alxhoff/Nixie-tube-clock/README.md

# stm32_nixie_clock_firmware
Firmware for a nixie tube clock based on STM32 hal libraries
