alxhoff/Nixie-tube-clock/hardware/nixie_2_digit_board/nixie_2_digit_board.kicad_pcb

## KiCad design hardware/nixie_2_digit_board/nixie_2_digit_board.kicad_pcb (2022-05-30)

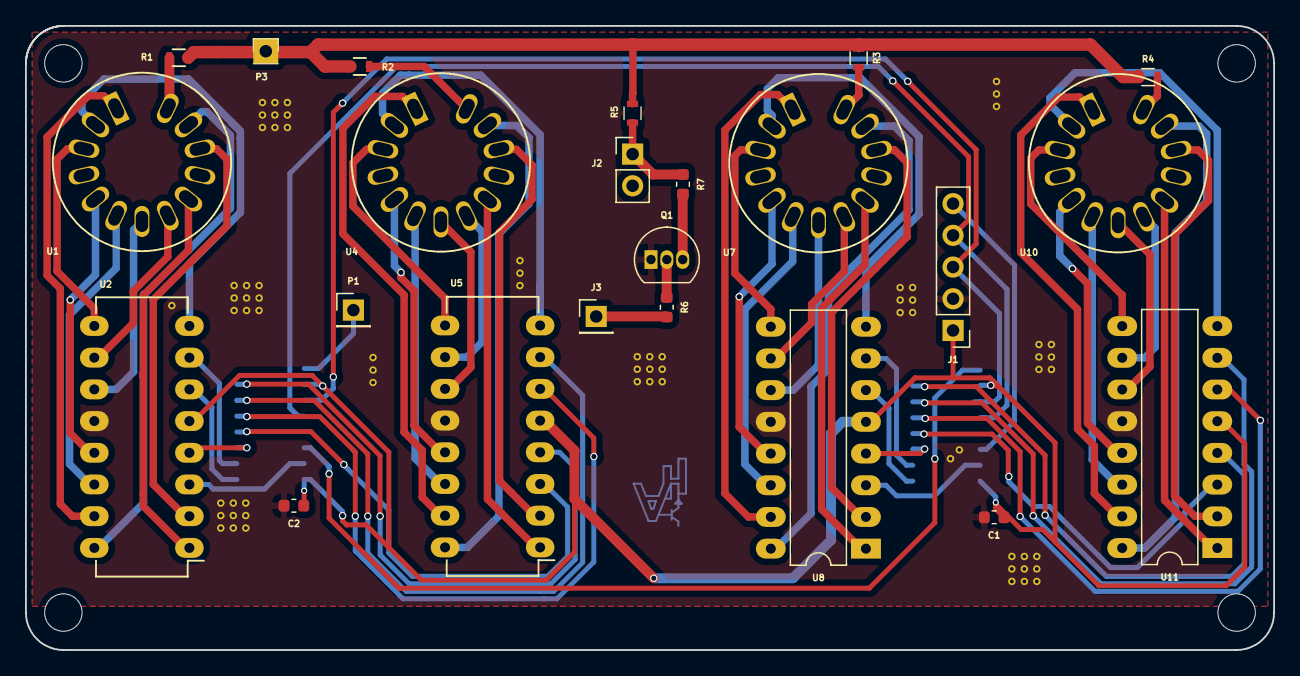
[picture p2: board nixie_2_digit_board.kicad_pcb from above]

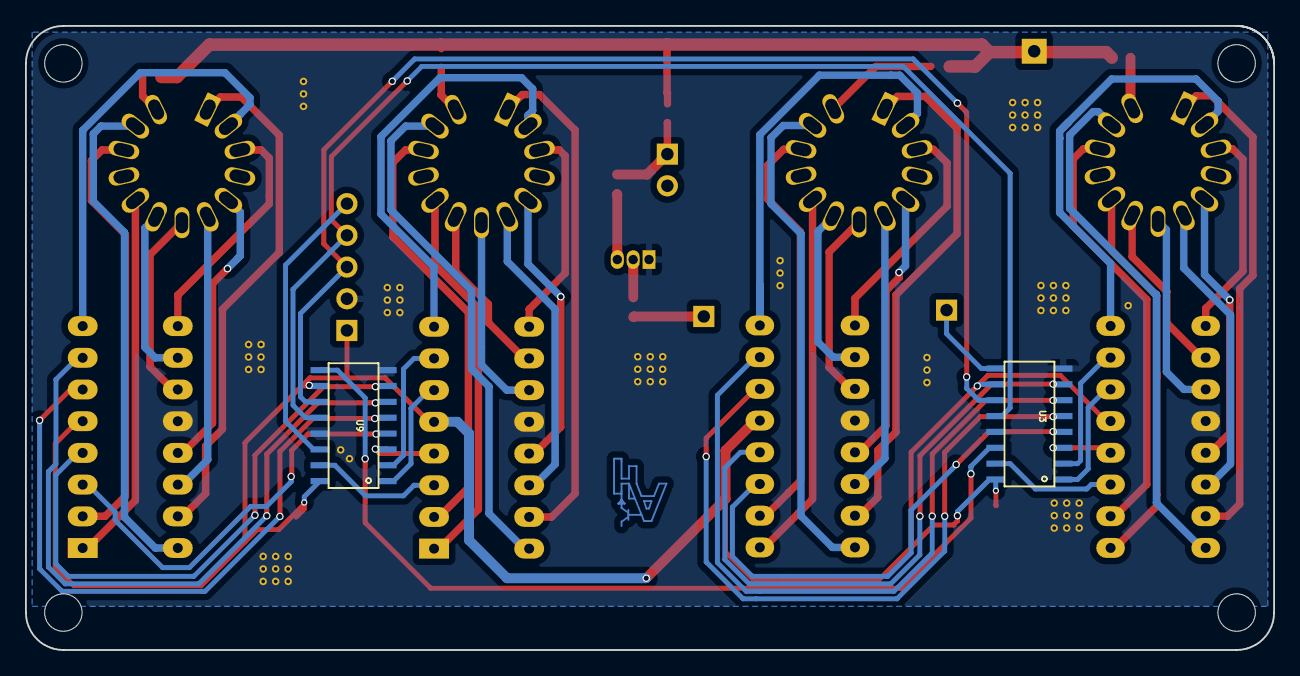
[picture p3: board nixie_2_digit_board.kicad_pcb from below]

Board: 2 copper layers, 100.0 x 50.0 mm, 26 parts (3 on the bottom side), 72 nets.

Parts:
C1, C2: 0.1uF; C_0603_1608Metric
J1: Conn_01x05; Pin_Header_Straight_1x05_Pitch2.54mm
J2: Dot Connection; Pin_Header_Straight_1x02_Pitch2.54mm
J3: GPIO in for dot; PinHeader_1x01_P2.54mm_Vertical
P1: CONN_01X01; Pin_Header_Straight_1x01_Pitch2.54mm
P3: CONN_01X01; Pin_Header_Straight_1x01
Q1: MPSA42; TO-92_Inline
R1, R2, R3, R4, R5: 15K; R_0603
R6: 10K; R_0603_1608Metric
R7: 15K; R_0603_1608Metric
U1, U4, U7, U10: 570Nixie; Nixie-570M-573M
U2, U5, U8, U11: SN74141-BCD-DEC-DECODE; DIP-16_W7.62mm_LongPads
U3, U9: SN43HC595; SOP16L
U6: Logo

Connections:
180V: P3.1, R1.1, R2.1, R3.1, R4.1, R5.2
+5V: C1.1, C2.1, J1.1, U2.5, U3.10, U3.16, U5.5, U8.5, U9.10, U9.16, U11.5
DOT_CTRL: J3.1, R6.2
GND: C1.2, C2.2, J1.2, Q1.1, U2.12, U3.8, U3.13, U5.12, U8.12, U9.8, U9.13, U11.12
unnamed: J2.1, R5.1, R7.1
unnamed: P1.1, U3.9
unnamed: Q1.2, R6.1
unnamed: Q1.3, R7.2
unnamed: R1.2, U1.13
unnamed: R2.2, U4.13
unnamed: R3.2, U7.13
unnamed: R4.2, U10.13
unnamed: U1.1, U2.15
unnamed: U1.2, U2.8
unnamed: U1.3, U2.9
unnamed: U1.5, U2.13
unnamed: U1.6, U2.14
unnamed: U1.7, U2.11
unnamed: U1.8, U2.10
unnamed: U1.9, U2.1
unnamed: U1.11, U2.2
unnamed: U1.12, U2.16
unnamed: U2.3, U3.15
unnamed: U2.4, U3.3
unnamed: U2.6, U3.1
unnamed: U2.7, U3.2
unnamed: U3.4, U5.3
unnamed: U3.5, U5.6
unnamed: U3.6, U5.7
unnamed: U3.7, U5.4
unnamed: U4.1, U5.15
unnamed: U4.2, U5.8
unnamed: U4.3, U5.9
unnamed: U4.5, U5.13
unnamed: U4.6, U5.14
unnamed: U4.7, U5.11
unnamed: U4.8, U5.10
unnamed: U4.9, U5.1
unnamed: U4.11, U5.2
unnamed: U4.12, U5.16
unnamed: U7.1, U8.15
unnamed: U7.2, U8.8
unnamed: U7.3, U8.9
unnamed: U7.5, U8.13
unnamed: U7.6, U8.14
unnamed: U7.7, U8.11
unnamed: U7.8, U8.10
unnamed: U7.9, U8.1
unnamed: U7.11, U8.2
unnamed: U7.12, U8.16
unnamed: U8.3, U9.15
unnamed: U8.4, U9.3
unnamed: U8.6, U9.1
unnamed: U8.7, U9.2
unnamed: U10.1, U11.15
unnamed: U10.2, U11.8
unnamed: U10.3, U11.9
unnamed: U10.5, U11.13
unnamed: U10.6, U11.14
unnamed: U10.7, U11.11
unnamed: U10.8, U11.10
unnamed: U10.9, U11.1
unnamed: U10.11, U11.2
unnamed: U10.12, U11.16
unnamed: U9.4, U11.3
unnamed: U9.7, U11.4
unnamed: U9.5, U11.6
unnamed: U9.6, U11.7
SHIFT_LATCH_CLOCK: J1.4, U3.12, U9.12
SHIFT_OUT: U3.14, U9.9
SHIFT_SERIAL_CLOCK: J1.3, U3.11, U9.11
SHIFT_SER_DATA: J1.5, U9.14
