alxhoff/Nixie-tube-clock/hardware/nixie_control_board/nixie_control_board.kicad_pcb

## KiCad design hardware/nixie_control_board/nixie_control_board.kicad_pcb (2022-05-30)

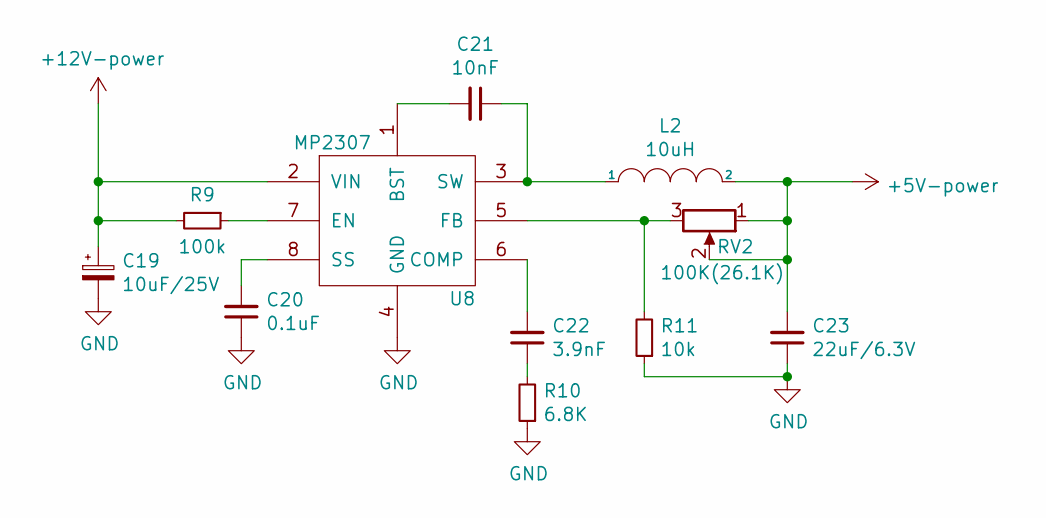
[picture p4: schematic buck_converter.kicad_sch]

Parts:
C19: 10uF/25V; C_1210_3225Metric
C20: 0.1uF; C_0603_1608Metric
C21: 10nF; C_0603_1608Metric
C22: 3.9nF; C_0603_1608Metric
C23: 22uF/6.3V; C_1206_3216Metric
L2: 10uH; Inductor_Wurth_HCI-7030
R9: 100k; R_0603_1608Metric
R10: 6.8K; R_0603_1608Metric
R11: 10k; R_0603_1608Metric
RV2: 100K(26.1K); Potentiometer_Trimmer-EVM3E
U8: MP2307; SOIC-8_3.9x4.9mm_P1.27mm

Connections:
+5V: C23.2, L2.2, RV2.1, RV2.2; also elsewhere on the board
+12V: C19.1, R9.2, U8.2 (VIN); also elsewhere on the board
GND: C19.2, C20.1, C23.1, R10.1, R11.1, U8.4 (GND); also elsewhere on the board
unnamed: C20.2, U8.8 (SS)
unnamed: C21.1, L2.1, U8.3 (SW)
unnamed: C21.2, U8.1 (BST)
unnamed: C22.1, R10.2
unnamed: C22.2, U8.6 (COMP)
unnamed: R9.1, U8.7 (EN)
unnamed: R11.2, RV2.3, U8.5 (FB)

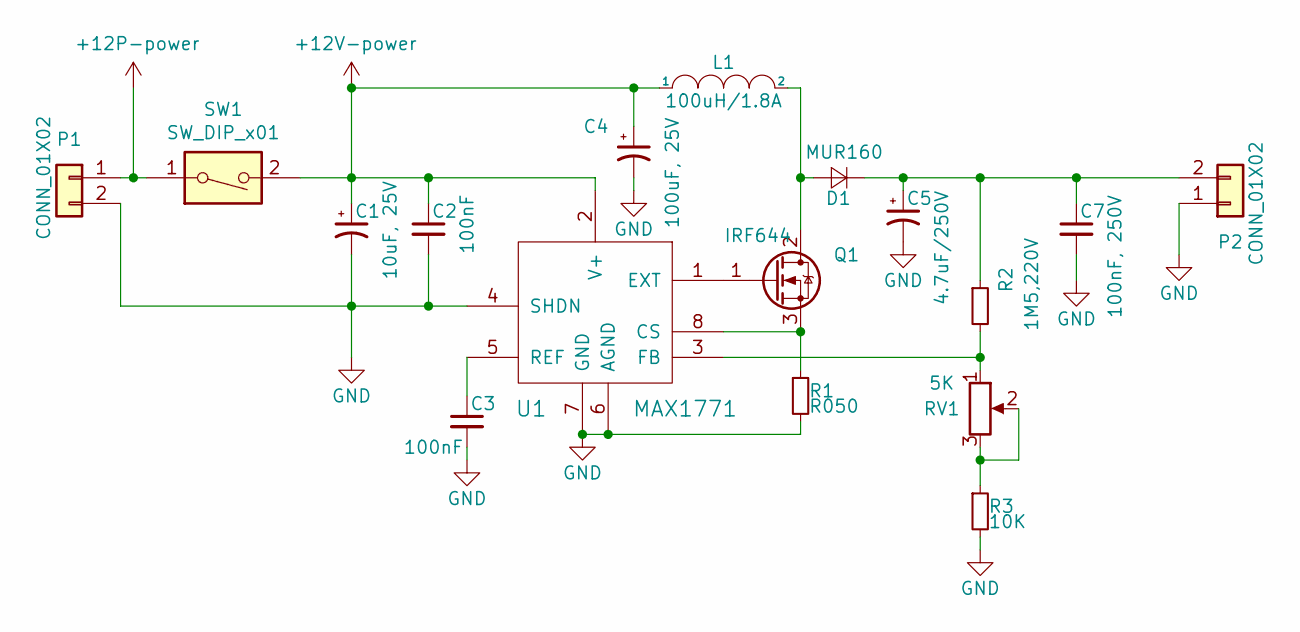
[picture p5: schematic nixie_supply.kicad_sch]

Parts:
C1: 10uF, 25V; C_1210_3225Metric
C2, C3: 100nF; C_0805_2012Metric
C4: 100uF, 25V; CP_EIA-7343-15_Kemet-W
C5: 4.7uF/250V; CP_Radial_D8.0mm_P3.80mm
C7: 100nF, 250V; C_1206_3216Metric
D1: MUR160; Diode_DO-41_SOD81_Horizontal_RM10
L1: 100uH/1.8A; L_12x12mm_H8mm
P1, P2: CONN_01X02; Power_connectors_5mm
Q1: IRF644; TO-220-3_Horizontal_TabDown
R1: R050; R_2512_6332Metric
R2: 1M5,220V; R_2512_6332Metric
R3: 10K; R_0603_1608Metric
RV1: 5K; Potentiometer_Trimmer-EVM3E
SW1: SW_DIP_x01; PinHeader_1x02_P2.54mm_Vertical
U1: MAX1771; SOP-8_3.9x4.9mm_P1.27mm

Connections:
+12P: P1.1, SW1.1
+12V: C1.1, C2.1, C4.1, L1.1, SW1.2, U1.2 (V+); also elsewhere on the board
GND: C1.2, C2.2, C3.2, C4.2, C5.2, C7.2, P1.2, P2.1, R1.2, R3.2, U1.4 (SHDN), U1.6 (AGND), U1.7 (GND); also elsewhere on the board
unnamed: C3.1, U1.5 (REF)
unnamed: C5.1, C7.1, D1.1 (K), P2.2, R2.1
unnamed: D1.2 (A), L1.2, Q1.2 (D)
unnamed: Q1.3 (S), R1.1, U1.8 (CS)
unnamed: R2.2, RV1.1, U1.3 (FB)
unnamed: R3.1, RV1.2, RV1.3
unnamed: Q1.1 (G), U1.1 (EXT)

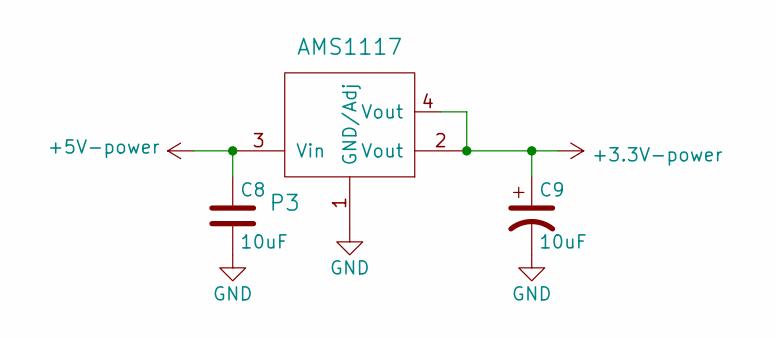
[picture p6: schematic 3v3_power.kicad_sch]

Parts:
C8, C9: 10uF; C_0603_1608Metric
P3: AMS1117; SOT-223

Connections:
+3V3: C9.1, P3.2 (Vout), P3.4 (Vout); also elsewhere on the board
+5V: C8.1, P3.3 (Vin); also elsewhere on the board
GND: C8.2, C9.2, P3.1 (GND/Adj); also elsewhere on the board

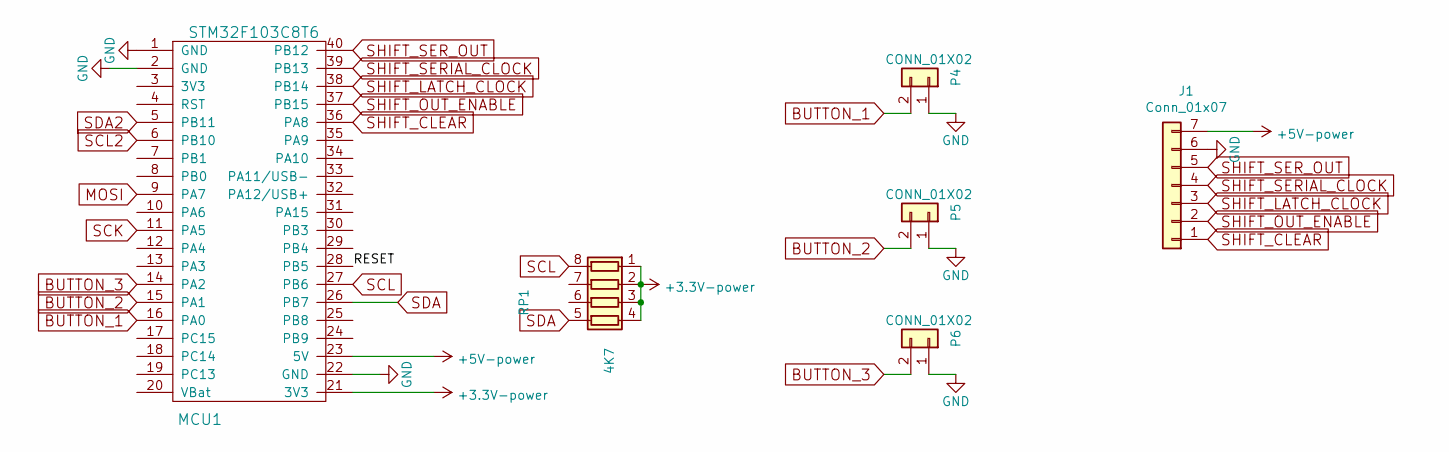
[picture p7: schematic controller.kicad_sch]

Parts:
J1: Conn_01x07; Pin_Header_Straight_1x07_Pitch2.54mm
MCU1: STM32F103C8T6
P4, P5, P6: CONN_01X02; PinHeader_1x02_P2.54mm_Vertical
RP1: 4K7; R_Array_Convex_4x0402

Connections:
+3V3: MCU1.21 (3V3), RP1.1 (R1.1), RP1.2 (R2.1), RP1.3 (R3.1), RP1.4 (R4.1); also elsewhere on the board
+5V: J1.7, MCU1.23 (5V); also elsewhere on the board
/Controller/RESET: MCU1.28 (PB5)
BUTTON_1: MCU1.16 (PA0), P4.2
BUTTON_2: MCU1.15 (PA1), P5.2
BUTTON_3: MCU1.14 (PA2), P6.2
GND: J1.6, MCU1.1 (GND), MCU1.2 (GND), MCU1.22 (GND), P4.1, P5.1, P6.1; also elsewhere on the board
MOSI: MCU1.9 (PA7)
SCK: MCU1.11 (PA5)
SCL: MCU1.27 (PB6), RP1.8 (R1.2); also elsewhere on the board
SCL2: MCU1.6 (PB10)
SDA: MCU1.26 (PB7), RP1.5 (R4.2); also elsewhere on the board
SDA2: MCU1.5 (PB11)
SHIFT_CLEAR: J1.1, MCU1.36 (PA8)
SHIFT_LATCH_CLOCK: J1.3, MCU1.38 (PB14)
SHIFT_OUT_ENABLE: J1.2, MCU1.37 (PB15)
SHIFT_SERIAL_CLOCK: J1.4, MCU1.39 (PB13)
SHIFT_SER_OUT: J1.5, MCU1.40 (PB12)

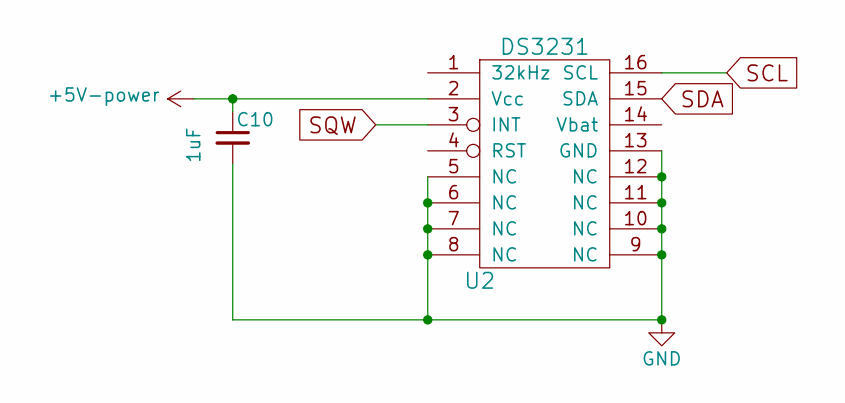
[picture p8: schematic rtc.kicad_sch]

Parts:
C10: 1uF; C_0603_1608Metric
U2: DS3231; SOIC-16W_7.5x10.3mm_P1.27mm

Connections:
+5V: C10.1, U2.2 (Vcc); also elsewhere on the board
GND: C10.2, U2.5 (NC), U2.6 (NC), U2.7 (NC), U2.8 (NC), U2.9 (NC), U2.10 (NC), U2.11 (NC), U2.12 (NC), U2.13 (GND); also elsewhere on the board
SCL: U2.16 (SCL); also elsewhere on the board
SDA: U2.15 (SDA); also elsewhere on the board
SQW: U2.3 (INT)

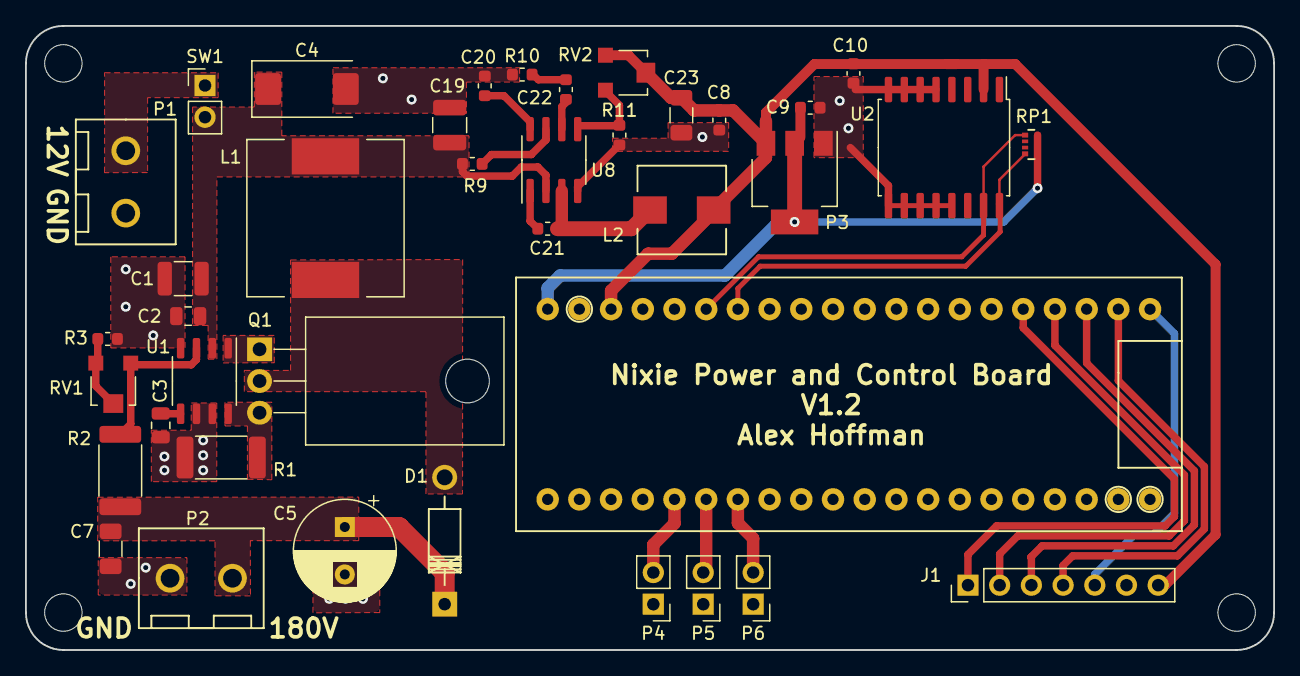
[picture p9: board nixie_control_board.kicad_pcb from above]

Board: 2 copper layers, 100.0 x 50.0 mm, 39 parts (0 on the bottom side), 29 nets.
