alxhoff/Nixie-tube-clock/Nixie_firmware/Inc/lwipopts.h

/**
  ******************************************************************************
  * File Name          : lwipopts.h
  * Description        : This file overrides LwIP stack default configuration
  *                      done in opt.h file.
  ******************************************************************************
  * This notice applies to any and all portions of this file
  * that are not between comment pairs USER CODE BEGIN and
  * USER CODE END. Other portions of this file, whether 
  * inserted by the user or by software development tools
  * are owned by their respective copyright owners.
  *
  * Copyright (c) 2017 STMicroelectronics International N.V. 
  * All rights reserved.
  *
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
  ******************************************************************************
  */
 
/* Define to prevent recursive inclusion --------------------------------------*/
#ifndef __LWIPOPTS__H__
#define __LWIPOPTS__H__

#include "stm32f4xx_hal.h"

/*-----------------------------------------------------------------------------*/
/* Current version of LwIP supported by CubeMx: 2.0.0 -*/
/*-----------------------------------------------------------------------------*/

/* Within 'USER CODE' section, code will be kept by default at each generation */
#ifdef __cplusplus
 extern "C" {
#endif

/* STM32CubeMX Specific Parameters (not defined in opt.h) ---------------------*/
/* Parameters set in STM32CubeMX LwIP Configuration GUI -*/
/*----- WITH_RTOS enabled (Since FREERTOS is set) -----*/
#define WITH_RTOS 1
/*----- CHECKSUM_BY_HARDWARE disabled -----*/
#define CHECKSUM_BY_HARDWARE 0
/*-----------------------------------------------------------------------------*/

/* LwIP Stack Parameters (modified compared to initialization value in opt.h) -*/
/* Parameters set in STM32CubeMX LwIP Configuration GUI -*/
/*----- Value in opt.h for MEM_ALIGNMENT: 1 -----*/
#define MEM_ALIGNMENT 4
/*----- Default Value for MEMP_NUM_SYS_TIMEOUT: 5 ---*/
#define MEMP_NUM_SYS_TIMEOUT 3
/*----- Value in opt.h for LWIP_ETHERNET: LWIP_ARP || PPPOE_SUPPORT -*/
#define LWIP_ETHERNET 1
/*----- Default Value for DHCP_DOES_ARP_CHECK: 1 ---*/
#define DHCP_DOES_ARP_CHECK 0
/*----- Value in opt.h for LWIP_DNS_SECURE: (LWIP_DNS_SECURE_RAND_XID | LWIP_DNS_SECURE_NO_MULTIPLE_OUTSTANDING | LWIP_DNS_SECURE_RAND_SRC_PORT) -*/
#define LWIP_DNS_SECURE 7
/*----- Value in opt.h for TCP_SND_QUEUELEN: (4*TCP_SND_BUF + (TCP_MSS - 1))/TCP_MSS -----*/
#define TCP_SND_QUEUELEN 9
/*----- Value in opt.h for TCP_SNDLOWAT: LWIP_MIN(LWIP_MAX(((TCP_SND_BUF)/2), (2 * TCP_MSS) + 1), (TCP_SND_BUF) - 1) -*/
#define TCP_SNDLOWAT 1071
/*----- Value in opt.h for TCP_SNDQUEUELOWAT: LWIP_MAX(TCP_SND_QUEUELEN)/2, 5) -*/
#define TCP_SNDQUEUELOWAT 5
/*----- Value in opt.h for TCP_WND_UPDATE_THRESHOLD: LWIP_MIN(TCP_WND/4, TCP_MSS*4) -----*/
#define TCP_WND_UPDATE_THRESHOLD 536
/*----- Value in opt.h for TCPIP_THREAD_STACKSIZE: 0 -----*/
#define TCPIP_THREAD_STACKSIZE 1024
/*----- Value in opt.h for TCPIP_THREAD_PRIO: 1 -----*/
#define TCPIP_THREAD_PRIO 3
/*----- Value in opt.h for TCPIP_MBOX_SIZE: 0 -----*/
#define TCPIP_MBOX_SIZE 6
/*----- Value in opt.h for SLIPIF_THREAD_STACKSIZE: 0 -----*/
#define SLIPIF_THREAD_STACKSIZE 1024
/*----- Value in opt.h for SLIPIF_THREAD_PRIO: 1 -----*/
#define SLIPIF_THREAD_PRIO 3
/*----- Value in opt.h for DEFAULT_THREAD_STACKSIZE: 0 -----*/
#define DEFAULT_THREAD_STACKSIZE 1024
/*----- Value in opt.h for DEFAULT_THREAD_PRIO: 1 -----*/
#define DEFAULT_THREAD_PRIO 3
/*----- Value in opt.h for DEFAULT_UDP_RECVMBOX_SIZE: 0 -----*/
#define DEFAULT_UDP_RECVMBOX_SIZE 6
/*----- Value in opt.h for DEFAULT_TCP_RECVMBOX_SIZE: 0 -----*/
#define DEFAULT_TCP_RECVMBOX_SIZE 6
/*----- Value in opt.h for DEFAULT_ACCEPTMBOX_SIZE: 0 -----*/
#define DEFAULT_ACCEPTMBOX_SIZE 6
/*----- Value in opt.h for RECV_BUFSIZE_DEFAULT: INT_MAX -----*/
#define RECV_BUFSIZE_DEFAULT 2000000000
/*----- Value in opt.h for LWIP_STATS: 1 -----*/
#define LWIP_STATS 0
/*----- Value in opt.h for CHECKSUM_GEN_IP: 1 -----*/
#define CHECKSUM_GEN_IP 0
/*----- Value in opt.h for CHECKSUM_GEN_UDP: 1 -----*/
#define CHECKSUM_GEN_UDP 0
/*----- Value in opt.h for CHECKSUM_GEN_TCP: 1 -----*/
#define CHECKSUM_GEN_TCP 0
/*----- Value in opt.h for CHECKSUM_GEN_ICMP: 1 -----*/
#define CHECKSUM_GEN_ICMP 0
/*----- Value in opt.h for CHECKSUM_GEN_ICMP6: 1 -----*/
#define CHECKSUM_GEN_ICMP6 0
/*----- Value in opt.h for CHECKSUM_CHECK_IP: 1 -----*/
#define CHECKSUM_CHECK_IP 0
/*----- Value in opt.h for CHECKSUM_CHECK_UDP: 1 -----*/
#define CHECKSUM_CHECK_UDP 0
/*----- Value in opt.h for CHECKSUM_CHECK_TCP: 1 -----*/
#define CHECKSUM_CHECK_TCP 0
/*----- Value in opt.h for CHECKSUM_CHECK_ICMP: 1 -----*/
#define CHECKSUM_CHECK_ICMP 0
/*----- Value in opt.h for CHECKSUM_CHECK_ICMP6: 1 -----*/
#define CHECKSUM_CHECK_ICMP6 0
/*-----------------------------------------------------------------------------*/
#ifdef __cplusplus
}
#endif
#endif /*__LWIPOPTS__H_H */

/************************* (C) COPYRIGHT STMicroelectronics *****END OF FILE****/
