alxhoff/Nixie-tube-clock/firmware/Core/Inc/main.h

#define BUT1_Pin GPIO_PIN_13
#define BUT1_GPIO_Port GPIOC
#define BUT1_EXTI_IRQn EXTI15_10_IRQn
#define SHIFT_SER_CLK_Pin GPIO_PIN_0
#define SHIFT_SER_CLK_GPIO_Port GPIOC
#define SHIFT_ENA_Pin GPIO_PIN_2
#define SHIFT_ENA_GPIO_Port GPIOC
#define SHIFT_CLR_Pin GPIO_PIN_3
#define SHIFT_CLR_GPIO_Port GPIOC
#define SHIFT_SER_IN_Pin GPIO_PIN_0
#define SHIFT_SER_IN_GPIO_Port GPIOA
#define BUT0_Pin GPIO_PIN_1
#define BUT0_GPIO_Port GPIOA
#define USART_TX_Pin GPIO_PIN_2
#define USART_TX_GPIO_Port GPIOA
#define USART_RX_Pin GPIO_PIN_3
#define USART_RX_GPIO_Port GPIOA
#define LD2_Pin GPIO_PIN_5
#define LD2_GPIO_Port GPIOA
#define BUT2_Pin GPIO_PIN_6
#define BUT2_GPIO_Port GPIOA
#define LD3_Pin GPIO_PIN_5
#define LD3_GPIO_Port GPIOC
#define SHIFT_LATCH_Pin GPIO_PIN_0
#define SHIFT_LATCH_GPIO_Port GPIOB
#define LD1_Pin GPIO_PIN_11
#define LD1_GPIO_Port GPIOA
#define TMS_Pin GPIO_PIN_13
#define TMS_GPIO_Port GPIOA
#define TCK_Pin GPIO_PIN_14
#define TCK_GPIO_Port GPIOA
#define SWO_Pin GPIO_PIN_3
#define SWO_GPIO_Port GPIOB
