alxhoff/Nixie-tube-clock/firmware/Core/Src/ds3231.c

/*
 * ds3231_stm32_alex.c
 *
 *  Created on: Aug 6, 2017
 *      Author: alxhoff
 */

#include <stdlib.h>
#include <string.h>

#include "ds3231.h"

typedef struct ds3231_registers {
	unsigned char sec;
	unsigned char min;
	unsigned char hour;
	unsigned char week_day;
	unsigned char date;
	unsigned char month;
	uint16_t year;
	unsigned char alarm1_sec;
	unsigned char alarm1_min;
	unsigned char alarm1_hour;
	unsigned char alarm1_date;
	unsigned char alarm2_min;
	unsigned char alarm2_hour;
	unsigned char alarm2_date;
	unsigned char control;
	unsigned char status;
	unsigned char offset;
	unsigned char MSB_temp;
	unsigned char LSB_temp;
} ds3231_registers_t;

unsigned char dec2bcd(unsigned char d) {
	return ((d / 10 * 16) + (d % 10));
}

unsigned char bcd2dec(unsigned char b) {
	return ((b / 16 * 10) + (b % 16));
}

//OBJECT ORIENTATED END

void DS3231_set_time_short(I2C_HandleTypeDef *hi2c, unsigned char twelve_hour,
		unsigned char hour, unsigned char min, unsigned char sec) {
	unsigned char write_buffer[3] = { 0 };
	write_buffer[0] = dec2bcd(sec);
	write_buffer[1] = dec2bcd(min);

	if (twelve_hour) {
		write_buffer[2] |= (1 << TWELVE_FLAG);
		if (hour >= 12) {
			write_buffer[2] |= (1 << PM_AM_FLAG);
			write_buffer[2] |= dec2bcd((hour & 0x1F) - 12);
		} else {
			write_buffer[2] &= ~(1 << PM_AM_FLAG);
			write_buffer[2] |= dec2bcd(hour & 0x1F);
		}
	} else {
		write_buffer[2] &= ~(1 << TWELVE_FLAG);
		write_buffer[2] |= dec2bcd(hour & 0x3F);
	}

	HAL_I2C_Mem_Write(hi2c, DS3231_ADDR8, 0x00, 1, write_buffer, 3, 10);
}

void DS3231_get_time_short(I2C_HandleTypeDef *hi2c, unsigned char *pm,
		unsigned char *twelve_hour, unsigned char *hour, unsigned char *min,
		unsigned char *sec) {
	unsigned char read_buffer[3];
	unsigned char return_hour;

	HAL_I2C_Mem_Read(hi2c, DS3231_ADDR8, 0x00, 1, read_buffer, 3, 10);

	*sec = bcd2dec(read_buffer[0]);
	*min = bcd2dec(read_buffer[1]);
	return_hour = read_buffer[2];

	if (return_hour & (1 << TWELVE_FLAG)) {
		//12 hour
		*twelve_hour = 1;
		if (return_hour & (1 << PM_AM_FLAG)) {
			//PM
			*pm = 1;
			*hour = bcd2dec(return_hour & 0x1F);
		} else {
			//AM
			*pm = 0;
			*hour = bcd2dec(return_hour & 0x1F);
		}
	} else {
		//24 hour
		*twelve_hour = 0;
		*hour = bcd2dec(return_hour & 0x3F);
	}
}

signed char DS3231_set_date(I2C_HandleTypeDef *hi2c, uint16_t year,
		unsigned char month, unsigned char date, unsigned char weekday) {
	unsigned char write_buffer[4];
	unsigned char century = 0;

	if (year > 2000) {
		century = 0x80;
		year -= 2000;
	} else {
		century = 0x00;
		year -= 1900;
	}

	write_buffer[0] = dec2bcd(weekday);
	write_buffer[1] = dec2bcd(date);
	write_buffer[2] = dec2bcd(month) | century;
	write_buffer[3] = dec2bcd(year);

	if (HAL_I2C_Mem_Write(hi2c, DS3231_ADDR8, 0x03, 1, write_buffer, 4, 10)
			!= HAL_OK)
		return -1;
	return 0;
}

signed char DS3231_get_date(I2C_HandleTypeDef *hi2c, uint16_t *year,
		unsigned char *month, unsigned char *date, unsigned char *weekday) {
	unsigned char read_buffer[4];
	volatile unsigned char century = 0;

	if (HAL_I2C_Mem_Read(hi2c, DS3231_ADDR8, 0x03, 1, read_buffer, 4, 10)
			!= HAL_OK)
		return -1;

	century = ((read_buffer[2] & 0x80) >> 7);
	*year = (
			century == 1 ?
					(2000 + bcd2dec(read_buffer[3])) :
					(1900 + bcd2dec(read_buffer[3])));
	*month = bcd2dec(read_buffer[2] & 0x1F);
	*date = bcd2dec(read_buffer[1] & 0x3F);
	*weekday = bcd2dec(read_buffer[0]);

	return 0;
}

signed char DS3231_set_time_sec(I2C_HandleTypeDef *hi2c, unsigned char sec) {
	unsigned char write_buffer = dec2bcd(sec);

	if (HAL_I2C_Mem_Write(hi2c, DS3231_ADDR8, 0x00, 1, &write_buffer, 1, 10)
			!= HAL_OK)
		return -1;

	return 0;
}

signed char DS3231_set_time_min(I2C_HandleTypeDef *hi2c, unsigned char min) {
	unsigned char write_buffer = dec2bcd(min);

	if (HAL_I2C_Mem_Write(hi2c, DS3231_ADDR8, 0x01, 1, &write_buffer, 1, 10)
			!= HAL_OK)
		return -1;

	return 0;
}

signed char DS3231_set_time_hour(I2C_HandleTypeDef *hi2c, unsigned char hour,
		TIME_FORMAT_e format, AM_OR_PM_e am_pm) {
	unsigned char write_buffer = 0;

	if (format) {
		write_buffer = dec2bcd(hour & 0x1F);
		if (am_pm == PM) {
			write_buffer |= (1 << PM_AM_FLAG) | (1 << TWELVE_FLAG);
		} else {
			write_buffer |= (1 << TWELVE_FLAG);
			write_buffer &= ~(1 << PM_AM_FLAG);
		}
	} else {
		write_buffer = dec2bcd(hour & 0x3F);
		hour &= ~(1 << TWELVE_FLAG);
	}

	if (HAL_I2C_Mem_Write(hi2c, DS3231_ADDR8, 0x02, 1, &write_buffer, 1, 10)
			!= HAL_OK)
		return -1;

	return 0;
}

signed char DS3231_set_time_day(I2C_HandleTypeDef *hi2c, unsigned char day) {
	unsigned char write_buffer = day & 0x07;

	if (HAL_I2C_Mem_Write(hi2c, DS3231_ADDR8, 0x03, 1, &write_buffer, 1, 10)
			!= HAL_OK)
		return -1;

	return 0;
}

signed char DS3231_set_time_date(I2C_HandleTypeDef *hi2c, unsigned char date) {
	unsigned char write_buffer = dec2bcd(date) & 0x3F;

	if (HAL_I2C_Mem_Write(hi2c, DS3231_ADDR8, 0x04, 1, &write_buffer, 1, 10)
			!= HAL_OK)
		return -1;

	return 0;
}

signed char DS3231_set_time_month(I2C_HandleTypeDef *hi2c, unsigned char month) {
	unsigned char read_buffer;
	unsigned char write_buffer = dec2bcd(month) & 0x1F;

	if (HAL_I2C_Mem_Read(hi2c, DS3231_ADDR8, 0x05, 1, &read_buffer, 1, 10)
			!= HAL_OK)
		return -1;

	if (read_buffer >> 7 && 0x01)
		write_buffer |= (1 << 7);

	if (HAL_I2C_Mem_Write(hi2c, DS3231_ADDR8, 0x05, 1, &write_buffer, 1, 10)
			!= HAL_OK)
		return -1;

	return 0;
}

signed char DS3231_set_time_year(I2C_HandleTypeDef *hi2c, unsigned short year) {
	unsigned char read_buffer;
	unsigned char write_buffer[2] = { 0 };

	if (HAL_I2C_Mem_Read(hi2c, DS3231_ADDR8, 0x05, 1, &read_buffer, 1, 10)
			!= HAL_OK)
		return -1;

	if (year >= 2000) {
		write_buffer[0] = read_buffer;
		write_buffer[0] &= ~(1 << 7);
		write_buffer[1] = (unsigned char) dec2bcd(year - 2000);
	} else {
		write_buffer[0] = read_buffer | (1 << 7);
		write_buffer[1] = (unsigned char) dec2bcd(year - 1900);
	}

	if (HAL_I2C_Mem_Write(hi2c, DS3231_ADDR8, 0x05, 1, write_buffer, 1, 10)
			!= HAL_OK)
		return -1;

	return 0;
}

signed char DS3231_set_time(I2C_HandleTypeDef *hi2c, ds3231_time_t *time) {
	unsigned char write_buffer[7];
	unsigned char century = 0, year = time->year;
	unsigned char hour;

	if (time->year >= 2000) {
		century = 0x80;
		year -= 2000;
	} else {
		century = 0x00;
		year -= 1900;
	}

	if (time->format) {
		hour = dec2bcd(time->hour & 0x1F);
		//12 hour
		if (time->am_or_pm == PM)
			//PM
			//set flags
			hour |= (1 << PM_AM_FLAG) | (1 << TWELVE_FLAG);
		else {
			//AM
			//set flags
			hour |= (1 << TWELVE_FLAG);
			hour &= ~(1 << PM_AM_FLAG);
		}
	} else {
		//24 hour
		hour = dec2bcd(time->hour & 0x3F);
		//set flags
		hour &= ~(1 << TWELVE_FLAG);
	}

	write_buffer[0] = dec2bcd(time->sec);
	write_buffer[1] = dec2bcd(time->min);
	write_buffer[2] = hour;
	write_buffer[3] = dec2bcd(time->weekday);
	write_buffer[4] = dec2bcd(time->date);
	write_buffer[5] = (dec2bcd(time->month) | century);
	write_buffer[6] = dec2bcd(year);

	if (HAL_I2C_Mem_Write(hi2c, DS3231_ADDR8, 0x00, 1, write_buffer, 7, 10)
			!= HAL_OK)
		return -1;

	return 0;
}

signed char DS3231_get_time(I2C_HandleTypeDef *hi2c,
		ds3231_time_t *return_struct) {
	unsigned char read_buffer[7];
	unsigned char century = 0;
	unsigned char hour_byte;

	if (HAL_I2C_Mem_Read(hi2c, DS3231_ADDR8, 0x00, 1, read_buffer, 7, 10)
			!= HAL_OK)
		return -1;

	hour_byte = read_buffer[2];

	if (hour_byte & (1 << TWELVE_FLAG)) {
		//12 hour
		return_struct->format = 1;
		if (hour_byte & (1 << PM_AM_FLAG)) {
			//PM
			return_struct->am_or_pm = PM;
		} else {
			//AM
			return_struct->am_or_pm = AM;
		}
		return_struct->hour = bcd2dec(hour_byte & 0x1F);
	} else {
		//24 hour
		return_struct->format = 0;
		return_struct->am_or_pm = AM;
		return_struct->hour = bcd2dec(hour_byte & 0x3F);
	}

	return_struct->sec = bcd2dec(read_buffer[0]);
	return_struct->min = bcd2dec(read_buffer[1]);
	return_struct->weekday = bcd2dec(read_buffer[3]);
	return_struct->date = bcd2dec(read_buffer[4]);
	return_struct->month = bcd2dec(read_buffer[5] & 0x1F);
	century = (read_buffer[5] & 0x80) >> 7;
	return_struct->year =
			century == 1 ?
					(2000 + bcd2dec(read_buffer[6])) :
					(1900 + bcd2dec(read_buffer[6]));

	return 0;
}

//untested
signed char DS3231_get_temp(I2C_HandleTypeDef *hi2c, float *temp) {
	unsigned char read_buffer[2];

	if (HAL_I2C_Mem_Read(hi2c, DS3231_ADDR8, 0x11, 1, read_buffer, 2, 10)
			!= HAL_OK)
		return -1;

	read_buffer[1] = (read_buffer[1] >> 6) * 25;

	*temp = ((((short) read_buffer[0] << 8) | (short) read_buffer[1]) >> 6)
			/ 4.0f;

	return 0;
}

void DS3231_register_dump(I2C_HandleTypeDef *hi2c,
		ds3231_registers_t *return_struct) {
	unsigned char read_buffer[19];

	HAL_I2C_Mem_Read(hi2c, DS3231_ADDR8, 0x00, 1, read_buffer, 20, 10);

	return_struct->sec = read_buffer[0];
	return_struct->min = read_buffer[1];
	return_struct->hour = read_buffer[2];
	return_struct->week_day = read_buffer[3];
	return_struct->date = read_buffer[4];
	return_struct->month = read_buffer[5];
	return_struct->year = read_buffer[6];
	return_struct->alarm1_sec = read_buffer[7];
	return_struct->alarm1_min = read_buffer[8];
	return_struct->alarm1_hour = read_buffer[9];
	return_struct->alarm1_date = read_buffer[10];
	return_struct->alarm2_min = read_buffer[11];
	return_struct->alarm2_hour = read_buffer[12];
	return_struct->alarm2_date = read_buffer[13];
	return_struct->control = read_buffer[14];
	return_struct->status = read_buffer[15];
	return_struct->offset = read_buffer[16];
	return_struct->MSB_temp = read_buffer[17];
	return_struct->LSB_temp = read_buffer[18];
}

//untested
signed char DS3231_set_alarm(I2C_HandleTypeDef *hi2c,
		ds3231_alarm_t *alarm_time, TIME_TYPE_e alarm_number) {
	unsigned char alarm_register_addr = 0x07;
	volatile unsigned char day_date_byte = 0x00;
	unsigned char write_buffer[4];

	//TODO last case
	switch (alarm_number) {
	case ALARM_ONE:
		alarm_register_addr = 0x07;
		break;
	case ALARM_TWO:
		alarm_register_addr = 0x0B;
		break;
	default:
		break;
	}

	write_buffer[0] = dec2bcd(alarm_time->sec) & 0x7F;
	write_buffer[1] = dec2bcd(alarm_time->min) & 0x7F;

	write_buffer[2] = 0x00;

	if (alarm_time->format) {
		//12 hour
		if (alarm_time->am_or_pm == PM) {
			//PM
			write_buffer[2] = bcd2dec(alarm_time->hour & 0x1F);
			write_buffer[2] |= (1 << PM_AM_FLAG) | (1 << TWELVE_FLAG);
		} else {
			//AM
			write_buffer[2] = dec2bcd(alarm_time->hour & 0x1F);
			//set flags
			write_buffer[2] |= (1 << TWELVE_FLAG);
			write_buffer[2] &= ~(1 << PM_AM_FLAG);
		}
	} else {
		//24 hours
		write_buffer[2] = dec2bcd(alarm_time->hour & 0x3F);
		//set flags
		write_buffer[2] &= ~(1 << TWELVE_FLAG);
	}

	if (alarm_time->day_or_date == DAY_OF_MONTH) {
		//Day of month, DY/DT flag false
		day_date_byte &= ~(1 << DAY_OR_DATE_FLAG);
		day_date_byte |= dec2bcd(alarm_time->date & 0x3F);
	} else {
		//Day of week, DY/DT flag true
		day_date_byte |= (1 << DAY_OR_DATE_FLAG);
		day_date_byte |= dec2bcd(alarm_time->weekday & 0x0F);
	}

	write_buffer[3] = day_date_byte;

	switch (alarm_time->type) {
	case ALARM_EVERY_SECOND:
		write_buffer[0] |= (1 << ALARM_MASK_BITS);
		write_buffer[1] |= (1 << ALARM_MASK_BITS);
		write_buffer[2] |= (1 << ALARM_MASK_BITS);
		write_buffer[3] |= (1 << ALARM_MASK_BITS);
		break;
	case ALARM_MATCH_SECONDS:
		write_buffer[0] &= ~(1 << ALARM_MASK_BITS);
		write_buffer[1] |= (1 << ALARM_MASK_BITS);
		write_buffer[2] |= (1 << ALARM_MASK_BITS);
		write_buffer[3] |= (1 << ALARM_MASK_BITS);
		break;
	case ALARM_MATCH_MINUTES:
		write_buffer[0] &= ~(1 << ALARM_MASK_BITS);
		write_buffer[1] &= ~(1 << ALARM_MASK_BITS);
		write_buffer[2] |= (1 << ALARM_MASK_BITS);
		write_buffer[3] |= (1 << ALARM_MASK_BITS);
		break;
	case ALARM_MATCH_HOURS:
		write_buffer[0] &= ~(1 << ALARM_MASK_BITS);
		write_buffer[1] &= ~(1 << ALARM_MASK_BITS);
		write_buffer[2] &= ~(1 << ALARM_MASK_BITS);
		write_buffer[3] |= (1 << ALARM_MASK_BITS);
		break;
	case ALARM_MATCH_DATE_OR_DAY:
		write_buffer[0] &= ~(1 << ALARM_MASK_BITS);
		write_buffer[1] &= ~(1 << ALARM_MASK_BITS);
		write_buffer[2] &= ~(1 << ALARM_MASK_BITS);
		write_buffer[3] &= ~(1 << ALARM_MASK_BITS);
		break;
	default:
		break;
	}
	if (alarm_number == ALARM_ONE) {
		if (HAL_I2C_Mem_Write(hi2c, DS3231_ADDR8, alarm_register_addr, 1,
				write_buffer, 4, 10) != HAL_OK)
			return -1;
	} else if (HAL_I2C_Mem_Write(hi2c, DS3231_ADDR8, alarm_register_addr, 1,
			write_buffer + sizeof(unsigned char), 3, 10) != HAL_OK)
		return -1;
	return 0;
}

//untested
signed char DS3231_get_alarm(I2C_HandleTypeDef *hi2c,
		ds3231_alarm_t *return_struct, TIME_TYPE_e alarm_number) {
	unsigned char read_buffer[4];
	volatile unsigned char alarm_register_addr = 0x00;

	//TODO last case
	switch (alarm_number) {
	case ALARM_ONE:
		alarm_register_addr = 0x07;
		break;
	case ALARM_TWO:
		alarm_register_addr = 0x0A; /* first byte is ignored, alarm starts at 0x0B */
		break;
	default:
		break;
	}

	if (HAL_I2C_Mem_Read(hi2c, DS3231_ADDR8, alarm_register_addr, 1,
			read_buffer, 4, 10) != HAL_OK)
		return -1;

	if (alarm_number == ALARM_ONE)
		return_struct->sec = bcd2dec(read_buffer[0] & 0x7F);
	return_struct->min = bcd2dec(read_buffer[1] & 0x7F);

	if (read_buffer[2] & (1 << TWELVE_FLAG)) {
		//12 hour
		return_struct->format = 1;
		if (read_buffer[2] & (1 << PM_AM_FLAG)) {
			//PM
			return_struct->am_or_pm = PM;
		} else {
			//AM
			return_struct->am_or_pm = AM;
		}
		return_struct->hour = bcd2dec(read_buffer[2] & 0x1F);
	} else {
		//24 hour
		return_struct->format = 0;
		return_struct->am_or_pm = AM;
		return_struct->hour = bcd2dec(read_buffer[2] & 0x3F);
	}

	if ((read_buffer[3] >> DAY_OR_DATE_FLAG) & 1) {
		//day of week
		return_struct->day_or_date = DAY_OF_WEEK;
		return_struct->weekday = bcd2dec(read_buffer[3] & 0x0F);
	} else {
		//day of month
		return_struct->day_or_date = DAY_OF_MONTH;
		return_struct->date = bcd2dec(read_buffer[3] & 0x3F);
	}

	return 0;
}

//untested
void DS3231_enable_alarms(I2C_HandleTypeDef *hi2c, TIME_TYPE_e alarm_number) {
	unsigned char control_register = 0x00;

	HAL_I2C_Mem_Read(hi2c, DS3231_ADDR8, 0x0E, 1, &control_register, 1, 10);

	switch (alarm_number) {
	case ALARM_ONE:
		control_register |= (1 << ALARM1_CRTL_ENABLE);
		break;
	case ALARM_TWO:
		control_register |= (1 << ALARM2_CRTL_ENABLE);
		break;
	case BOTH:
		control_register |= (1 << ALARM1_CRTL_ENABLE);
		control_register |= (1 << ALARM2_CRTL_ENABLE);
		break;
	default:
		break;
	}

	HAL_I2C_Mem_Write(hi2c, DS3231_ADDR8, 0x0E, 1, &control_register, 1, 10);
}

//untested
void DS3231_enable_alarm_interrupt(I2C_HandleTypeDef *hi2c) {
	unsigned char control_register = 0x00;

	HAL_I2C_Mem_Read(hi2c, DS3231_ADDR8, 0x0E, 1, &control_register, 1, 10);

	control_register |= (1 << ALARM_INTERRUPT_ENABLE);

	HAL_I2C_Mem_Write(hi2c, DS3231_ADDR8, 0x0E, 1, &control_register, 1, 10);
}

//untested
void DS3231_disable_alarms(I2C_HandleTypeDef *hi2c, TIME_TYPE_e alarm_number) {
	unsigned char control_register = 0x00;

	HAL_I2C_Mem_Read(hi2c, DS3231_ADDR8, 0x0E, 1, &control_register, 1, 10);

	switch (alarm_number) {
	case ALARM_ONE:
		control_register &= ~(1 << ALARM1_CRTL_ENABLE);
		break;
	case ALARM_TWO:
		control_register &= ~(1 << ALARM2_CRTL_ENABLE);
		break;
	case BOTH:
		control_register &= ~(1 << ALARM1_CRTL_ENABLE);
		control_register &= ~(1 << ALARM2_CRTL_ENABLE);
		break;
	default:
		break;
	}

	HAL_I2C_Mem_Write(hi2c, DS3231_ADDR8, 0x0E, 1, &control_register, 1, 10);
}

//untested
void DS3231_disable_alarm_interrupt(I2C_HandleTypeDef *hi2c) {
	unsigned char control_register = 0x00;

	HAL_I2C_Mem_Read(hi2c, DS3231_ADDR8, 0x0E, 1, &control_register, 1, 10);

	control_register &= ~(1 << ALARM_INTERRUPT_ENABLE);

	HAL_I2C_Mem_Write(hi2c, DS3231_ADDR8, 0x0E, 1, &control_register, 1, 10);
}

//untested
void DS3231_change_wave_freq(I2C_HandleTypeDef *hi2c, WAVE_FREQ_e frequency) {
	unsigned char control_register = 0x00;

	HAL_I2C_Mem_Read(hi2c, DS3231_ADDR8, 0x0E, 1, &control_register, 1, 10);

	switch (frequency) {
	case ONE_K:
		control_register &= ~(1 << RS1 | 1 << RS2);
		break;
	case ONE_POINT_K:
		control_register |= (1 << RS1);
		control_register &= ~(1 << RS2);
		break;
	case FOUR_K:
		control_register &= ~(1 << RS1);
		control_register |= (1 << RS2);
		break;
	case EIGHT_K:
		control_register |= (1 << RS1 | 1 << RS2);
		break;
	default:
		break;
	}

	control_register |= (1 << ALARM_INTERRUPT_ENABLE);

	HAL_I2C_Mem_Write(hi2c, DS3231_ADDR8, 0x0E, 1, &control_register, 1, 10);
}

//untested
void DS3231_stop_triggered_alarms(I2C_HandleTypeDef *hi2c) {
	unsigned char status_register = 0x00;

	HAL_I2C_Mem_Read(hi2c, DS3231_ADDR8, 0x0F, 1, &status_register, 1, 10);

	status_register &= ~(1 << ALARM1_STATUS | 1 << ALARM1_STATUS);

	HAL_I2C_Mem_Write(hi2c, DS3231_ADDR8, 0x0F, 1, &status_register, 1, 10);
}
