alxhoff/Nixie-tube-clock/Nixie_firmware/Src/httpserver-netconn.c

/**
  ******************************************************************************
  * @file    LwIP/LwIP_HTTP_Server_Netconn_RTOS/Src/httpser-netconn.c 
  * @author  MCD Application Team
  * @version V1.0.0
  * @date    18-November-2015
  * @brief   Basic http server implementation using LwIP netconn API  
  ******************************************************************************
  * @attention
  *
  * <h2><center>&copy; COPYRIGHT(c) 2015 STMicroelectronics</center></h2>
  *
  * Licensed under MCD-ST Liberty SW License Agreement V2, (the "License");
  * You may not use this file except in compliance with the License.
  * You may obtain a copy of the License at:
  *
  *        http://www.st.com/software_license_agreement_liberty_v2
  *
  * Unless required by applicable law or agreed to in writing, software 
  * distributed under the License is distributed on an "AS IS" BASIS, 
  * WITHOUT WARRANTIES OR CONDITIONS OF ANY KIND, either express or implied.
  * See the License for the specific language governing permissions and
  * limitations under the License.
  *
  ******************************************************************************
  */

/* Includes ------------------------------------------------------------------*/
#include "lwip/opt.h"
#include "lwip/arch.h"
#include "lwip/api.h"
#include "string.h"
#include "httpserver-netconn.h"
#include "cmsis_os.h"
#include "../webpages/index.h"
#include "../webpages/control.h"
#include "../webpages/about.h"
#include "temp.h"
#include "lwip.h"
#include "ds3231_stm32_alex.h"
#include "externs.h"

/* Private typedef -----------------------------------------------------------*/
/* Private define ------------------------------------------------------------*/
#define WEBSERVER_THREAD_PRIO    ( tskIDLE_PRIORITY + 4 )

/* Private macro -------------------------------------------------------------*/
/* Private variables ---------------------------------------------------------*/
u32_t nPageHits = 0;

/* Private function prototypes -----------------------------------------------*/
/* Private functions ---------------------------------------------------------*/

/**
  * @brief serve tcp connection  
  * @param conn: pointer on connection structure 
  * @retval None
  */
void http_server_serve(struct netconn *conn) 
{
  struct netbuf *inbuf;
  err_t recv_err;
  char* buf;
  u16_t buflen;

  /* Read the data from the port, blocking if nothing yet there. 
   We assume the request (the part we care about) is in one netbuf */
  recv_err = netconn_recv(conn, &inbuf);
  
  if (recv_err == ERR_OK)
  {
    if (netconn_err(conn) == ERR_OK) 
    {
      netbuf_data(inbuf, (void**)&buf, &buflen);
    
      /* Is this an HTTP GET command? (only check the first 5 chars, since
      there are other formats for GET, and we're keeping it very simple )*/
      if ((buflen >=5) && (strncmp(buf, "GET /", 5) == 0))
      {
    	  //INDEX.html
    	  if (strncmp((char const *)buf,"GET /index.html",15)==0) {
    		  netconn_write(conn, (const unsigned char*)index_html, index_html_len, NETCONN_NOCOPY);
    	  }
    	  //CONTROL.html
    	  if (strncmp((char const *)buf, "GET /control.html", 17)==0) {
    		  netconn_write(conn, (const unsigned char*)control_html, control_html_len, NETCONN_NOCOPY);
    	  }
    	  //ABOUT.html
    	  if (strncmp((char const *)buf, "GET /about.html", 15)==0) {
    		  netconn_write(conn, (const unsigned char*)about_html, about_html_len, NETCONN_NOCOPY);
    	  }

    	  //TEST LED
    	  if (strncmp((char const *)buf,"GET /led3", 9) == 0) {
    		  HAL_GPIO_TogglePin(LD3_GPIO_Port, LD3_Pin);
    	  }

    	  //SET TASKS
    	  if (strncmp((char const *)buf,"GET /setip", 10) == 0) {
    		  //BREAKS SYSTEM

    		  IP_ADDRESS[3] = 221;
    		  IP4_ADDR(&ipaddr, IP_ADDRESS[0], IP_ADDRESS[1], IP_ADDRESS[2], IP_ADDRESS[3]);
    		  netif_set_addr(&gnetif, &ipaddr, &netmask, &gw);
    	  }
    	  if (strncmp((char const *)buf,"GET /setnetmask", 15) == 0) {

    	  }
    	  if (strncmp((char const *)buf,"GET /setgateway", 15) == 0) {

    	  }

    	  //IP, NETMASK and GATEWAY
    	  if (strncmp((char const *)buf,"GET /ip", 7) == 0) {
    		  //FORM IP STRING
    		  sprintf(buf, "%d.%d.%d.%d", IP_ADDRESS[0], IP_ADDRESS[1], IP_ADDRESS[2], IP_ADDRESS[3]);
    		  netconn_write(conn, (const unsigned char*)buf, strlen(buf), NETCONN_NOCOPY);
    	  }
    	  if (strncmp((char const *)buf,"GET /netmask", 12) == 0) {
    		  //FORM NETMASK STRING
    		  sprintf(buf, "%d.%d.%d.%d", NETMASK_ADDRESS[0], NETMASK_ADDRESS[1], NETMASK_ADDRESS[2], NETMASK_ADDRESS[3]);
    		  netconn_write(conn, (const unsigned char*)buf, strlen(buf), NETCONN_NOCOPY);
    	  }
    	  if (strncmp((char const *)buf,"GET /gateway", 12) == 0) {
    		  //FORM GATEWAT STRING
    		  sprintf(buf, "%d.%d.%d.%d", GATEWAY_ADDRESS[0], GATEWAY_ADDRESS[1], GATEWAY_ADDRESS[2], GATEWAY_ADDRESS[3]);
    		  netconn_write(conn, (const unsigned char*)buf, strlen(buf), NETCONN_NOCOPY);
    	  }

    	  //MCU TEMP
    	  if (strncmp((char const *)buf,"GET /adc", 8) == 0) {
    		  sprintf(buf, "%2.1f °C", getMCUTemperature());
    		  netconn_write(conn, (const unsigned char*)buf, strlen(buf), NETCONN_NOCOPY);
    	  }

    	  //TIME
    	  if (strncmp((char const *)buf,"GET /time", 8) == 0) {
    		  ds3231Time get_time = {0};
    		  DS3231_get_time(&hi2c2, &get_time);
    		  buf = get_time_string(&get_time);
    		  netconn_write(conn, (const unsigned char*)buf, strlen(buf), NETCONN_NOCOPY);
    	  }

    	  //TEMPS
    	  float dummytemps[6];
    	  dummytemps[0] = 12.5;
    	  dummytemps[1] = 18.54;
    	  dummytemps[2] = 15.23;
    	  dummytemps[3] = 12.54;
    	  dummytemps[4] = 23.12;
    	  dummytemps[5] = 12.32;
    	  for(int i=0;i<NUM_OF_TEMPS;i++){
    		  char temp_str[] = "GET /tempx";
    		  sprintf(temp_str, "GET /temp%d", i);
			  if (strncmp((char const *)buf, temp_str, 10) == 0) {
				  sprintf(buf, "%2.2f °C", dummytemps[i]);
				  netconn_write(conn, (const unsigned char*)buf, strlen(buf), NETCONN_NOCOPY);
			  }
    	  }

    	  //setip bytes
    	  if (strncmp((char const *)buf,"POST /SETIP", 10) == 0) {
    		  HAL_GPIO_TogglePin(LD3_GPIO_Port, LD3_Pin);
		  }
      }
    }
  }
  /* Close the connection (server closes in HTTP) */
  netconn_close(conn);
  
  /* Delete the buffer (netconn_recv gives us ownership,
   so we have to make sure to deallocate the buffer) */
  netbuf_delete(inbuf);
}


/**
  * @brief  http server thread 
  * @retval None
  */
static void http_server_netconn_thread()
{ 
  struct netconn *conn, *newconn;
  err_t err, accept_err;
  
  /* Create a new TCP connection handle */
  conn = netconn_new(NETCONN_TCP);
  
  if (conn!= NULL)
  {
    /* Bind to port 80 (HTTP) with default IP address */
    err = netconn_bind(conn, NULL, 80);
    
    if (err == ERR_OK)
    {
      /* Put the connection into LISTEN state */
      netconn_listen(conn);
  
      while(1) 
      {
        /* accept any icoming connection */
        accept_err = netconn_accept(conn, &newconn);
        if(accept_err == ERR_OK)
        {
          /* serve connection */
          http_server_serve(newconn);

          /* delete connection */
          netconn_delete(newconn);
        }
      }
    }
  }
}

/**
  * @brief  Initialize the HTTP server (start its thread) 
  * @param  none
  * @retval None
  */
void http_server_netconn_init()
{
  sys_thread_new("HTTP", http_server_netconn_thread, NULL, DEFAULT_THREAD_STACKSIZE, WEBSERVER_THREAD_PRIO);
}
