alxhoff/Nixie-tube-clock/Nixie_firmware/Inc/httpserver-netconn.h

#ifndef __HTTPSERVER_NETCONN_H__
#define __HTTPSERVER_NETCONN_H__

#define NUM_OF_TEMPS	6

void http_server_netconn_init(void);
void DynWebPage(struct netconn *conn);

#endif /* __HTTPSERVER_NETCONN_H__ */
