alxhoff/Nixie-tube-clock/(commit log)

2017-09-13 initial copy across from old repo, needs adapting to purpose
    [Nucleo144LMU2 Run.cfg]
2017-09-16 STM32F4 cube frame work ready for porting from past project
    [Nixie_firnware Run.cfg, Nucleo144LMU2 Run.cfg]
2017-09-16 GPIO and I2C configs
2017-09-17 files copied over from previous project, builds
    [Nixie_firnware Run.cfg, Nucleo144LMU2 Debug.cfg, Nucleo144LMU2 Run.cfg]
2017-10-06 old project removed
    [Nucleo144LMU2 Debug.cfg, Nucleo144LMU2 Run.cfg]
2017-10-09 stm32f1 project
2017-10-25 CUBE config matched pcb
    [Nixie_firmware Debug.cfg, nixie_clock Debug.cfg]
2017-10-28 zzzzz redone project for nucleoF103RB with propper debug config
    [Nixie_firmware Debug.cfg, Nixie_firnware Run.cfg, nucleo_nixie_clock Run.cfg]
2017-10-29 buttons added and mapped to three button config
2017-10-29 moved project to non-rtos project, buttons are getting debounced input
    [nucleo_nixie_clock_no_rtos Run.cfg]
2017-11-02 middle button jumps from disp to set for each function
2018-07-13 prototype shift working
2018-07-14 prototype displaying seconds
2018-07-23 blue pill test code started
    [nixie_clock Debug.cfg, nixie_tube_clock Debug.cfg, stm32f103.cfg]
2019-02-02 Debug files refreshed
    [New_configuration.cfg, nucleo_nixie_clock_no_rtos Debug.cfg]
2019-02-02 Let the hacking begin :)
    [New_configuration.cfg, no_rtos_debug.cfg]
2019-02-02 Nixie code cut down
2019-02-03 Alarm printing added, needs testing
2019-02-03 Alarm 2 printing
2019-02-03 Clean up
    [New_configuration.cfg, nixie_tube_clock Debug.cfg, no_rtos_debug.cfg, nucleo_nixie_clock Run.cfg, stm32f103.cfg]
2019-02-04 Hardware updates, bluepill projects added
    [buck_converter.sch, eeprom_array.sch, nixie_2_digit_board-2018-07-23-23-56-05.sch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]
2019-02-05 Control board updated to encorporate 5v step down and 3.3v reg
    [buck_converter.sch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]
2019-02-06 Firmware migrated to newer stm version
    [nucleo_nixie_clock_no_rtos Debug.cfg]
2019-02-06 Button interrupt configs and callback added
2019-02-06 Fixed double interrupt firing
    [main.c]
2019-02-07 Control board updated to be skinnier and ditch decondary through hole connections
    [nixie_control_board-B.Cu.gbl, nixie_control_board-B.Mask.gbs, nixie_control_board-B.Paste.gbp, nixie_control_board-B.SilkS.gbo, nixie_control_board-Edge.Cuts.gm1, nixie_control_board-F.Cu.gtl, nixie_control_board-F.Mask.gts, nixie_control_board-F.Paste.gtp]
2019-02-09 Button debounce code added
2019-02-14 Time set states buttons handled for iterating through set items
2019-02-16 Shifting between big states fixed
    [buttons.c, draw.c]
2019-02-19 Fixed screen crashing bug
    [config.h, draw.c, main.c, screen.c, screen_API.h, states.c]
2019-02-19 PCB Identifiers corrected
    [nixie_control_board.kicad_pcb]
2019-03-02 Screen fixed to abstract FB from screen driver
    [draw.c, screen.c, screen.h]
2019-03-02 fixed shift code, turns out c1 on my nucleo is toast
    [SN54HC595.c, config.h, main.c, main.h, nixie.c]
2019-03-02 Nixie tube output fixed
    [config.h, main.c, nixie.c, screen.c, screen.h]
2019-03-02 Nixie tube output properly fixed
    [config.h, nixie.c]
2019-03-06 Transistor switch added to dot on nixie board
    [nixie_2_digit_board.kicad_pcb]
2020-03-31 control board gerber
    [nixie_control_board-B.Cu.gbl, nixie_control_board-B.Mask.gbs, nixie_control_board-B.Paste.gbp, nixie_control_board-B.SilkS.gbo, nixie_control_board-B_Cu.gbl, nixie_control_board-B_Mask.gbs, nixie_control_board-B_SilkS.gbo, nixie_control_board-Edge_Cuts.gm1]
2020-03-31 nixie board gerber
    [nixie_2_digit_board-B.Cu.gbl, nixie_2_digit_board-B.Mask.gbs, nixie_2_digit_board-B.Paste.gbp, nixie_2_digit_board-B_Cu.gbl, nixie_2_digit_board-B_Mask.gbs, nixie_2_digit_board-B_SilkS.gbo, nixie_2_digit_board-Edge_Cuts.gm1, nixie_2_digit_board-F.Cu.gtl]
2020-04-18 Large clean up of old code, reworked state machine
    [RTC_dev.c, RTC_dev.h, SN54HC595.c, config.h, draw.c, draw.h, ds3231.c, ds3231.h]
2020-04-20 Updated 180V boost supply and updated gitignore
    [buck_converter.sch, nixie_control_board.kicad_pcb, nixie_control_board.sch]
2020-04-25 Clean up and minor fixes
    [SN54HC595.c, config.h, draw.c, nixie.c, user_states.h]
2020-04-25 Added empty bluepill project and moved RT clock battery holder
    [New_configuration.cfg, nixie_control_board.kicad_pcb, nixie_control_board.sch, nucleo_nixie_clock_no_rtos Debug.cfg]
2020-04-25 Button testing task added
    [nixie_control_board.sch]
2020-04-26 Added pullups to I2C1
    [nixie_control_board.kicad_pcb, nixie_control_board.sch]
2020-04-27 I2C Working on bluepill
    [nixie_control_board.kicad_pcb, nixie_control_board.sch]
2022-05-29 Some hardware changes
    [nixie_control_board.kicad_pcb, nixie_control_board.sch]
2022-05-30 First fixup after looking at this after 2 years
    [3v3_power.kicad_sch, buck_converter.kicad_sch, controller.kicad_sch, nixie_control_board.kicad_pcb, nixie_control_board.kicad_sch, nixie_supply.kicad_sch, rtc.kicad_sch]
2022-05-30 V1.2 Control board
    [nixie_2_digit_board.kicad_pcb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]
2022-06-05 Updated after a few years, not tested working
    [3v3_power.kicad_sch, New_configuration.cfg, buck_converter.kicad_sch, buck_converter.sch, controller.kicad_sch, eeprom_array.sch, nixie_2_digit_board-2018-07-23-23-56-05.sch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]
